AresRivas/Whame/Whame Project/Arduino SW/README.txt

Software for Arduino Nano Every, not tested in other boards. 

There are two different softwares dependind on where you are going to wear it, one for head and another for hand. 

Known bug: Some times the starting calibration fails and the system report Overflow for the YAW value, so click doesn't work. Solution: Reboot the system. 

If anyone solve this problem or preform any improve to the software please rename the code with version 1.1.
