AresRivas/Whame/Whame Project/Materials/Materials list.txt

1--> Arduino Nano Every

1--> Accelerometer MPU6050

1--> Bluetooth module Roving Networks RN42

1--> 1200 mAh LiPo Battery:

https://tienda.bricogeek.com/baterias-lipo/1135-bateria-lipo-1200mah-37v.html

1--> Power Booster & battery charger MP2636: 

https://tienda.bricogeek.com/convertidores-de-voltaje/1031-power-booster-mp2636-2a.html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 

1--> Switch:

https://tienda.bricogeek.com/interruptores/912-mini-interruptor-para-prototipado.html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

1--> FTDI Cable:

https://www.mouser.es/ProductDetail/FTDI/UMFT234XD-WE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

1--> Resistor ? 10k - 1/4W
1--> Resistor ? 22k - 1/4W  

Notes: The FTDI cable is optional for more confortable configuring the RN42 module, but it can be configured connecting it to the Arduino Nano hardware serial port (pins D0 and D1) with a simple circuit.
