AresRivas/Whame/Whame Project/3D Print Box/Micro USB Cover.stl

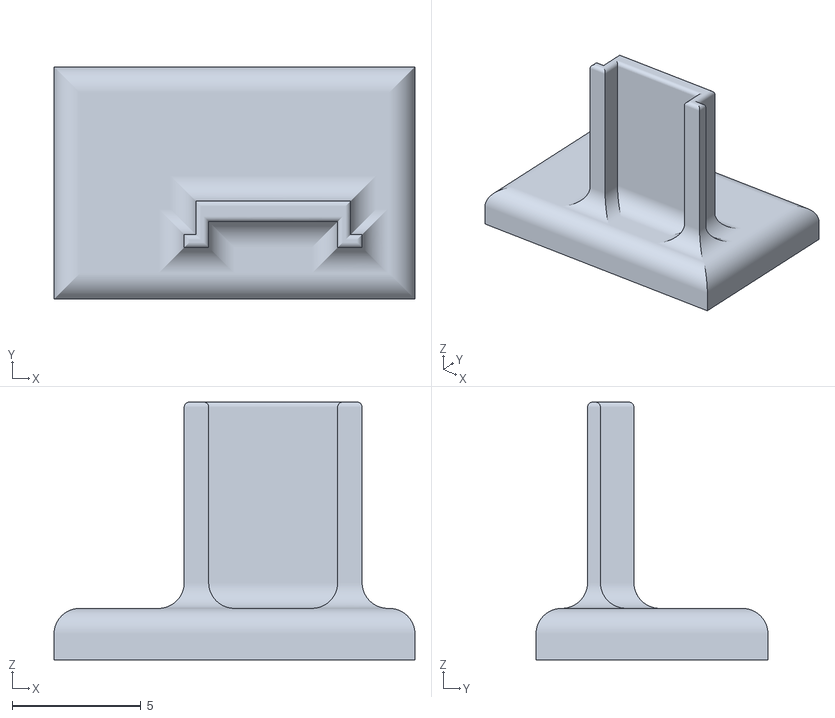
[picture p1: CAD file, 2022-05-29]
Whame Project/3D Print Box/Micro USB Cover.stl
14.0 x 9.00 x 10.0
