AresRivas/Whame/Whame Project/3D Print Box/Whame Top Cover.stl

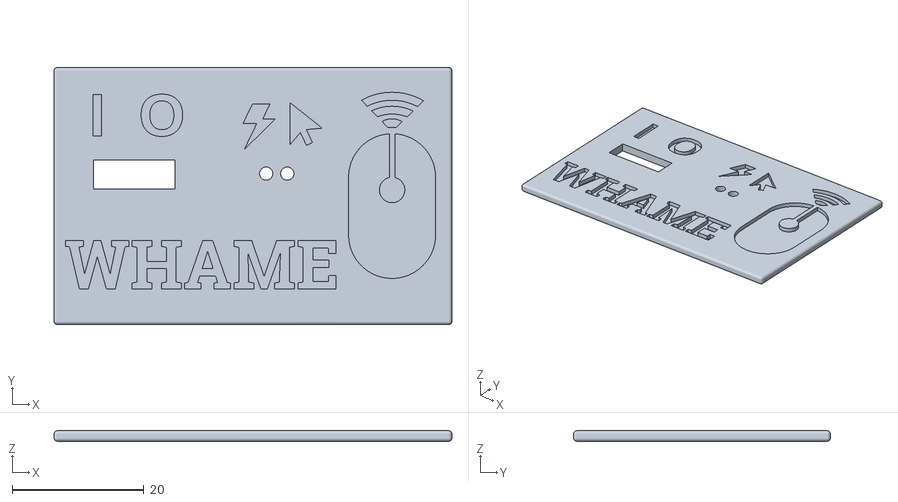
[picture p2: CAD file, 2022-05-29]
Whame Project/3D Print Box/Whame Top Cover.stl
60.4 x 39.0 x 1.60
