AresRivas/Whame/Whame Project/HW Design/PCB Model/Whame.kicad_pcb

## KiCad design Whame Project/HW Design/PCB Model/Whame.kicad_pcb (2022-06-05)

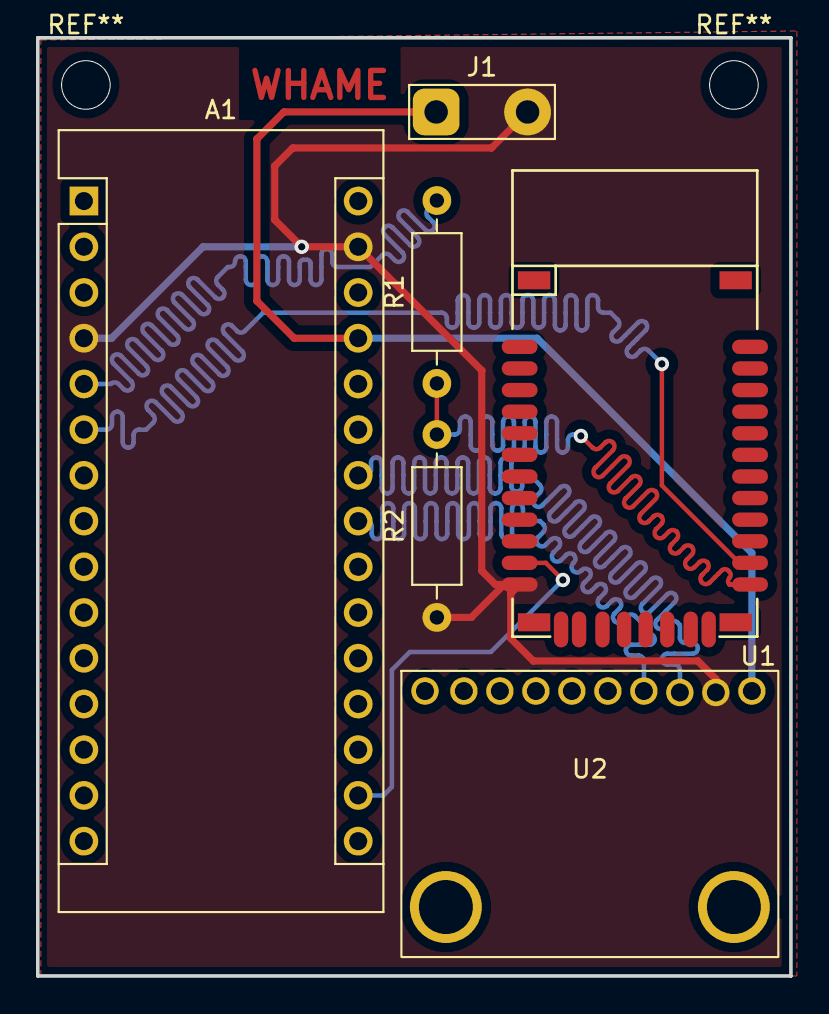
[picture p3: board Whame.kicad_pcb from above]

Board: 2 copper layers, 41.8 x 52.1 mm, 6 parts (0 on the bottom side), 8 nets.

Parts:
A1: Arduino_Nano_Every; Arduino_Nano
J1: Conn_01x02_Female; TestPoint_2Pads_Pitch5.08mm_Drill1.3mm
R1: 10k-1/2W; R_Axial_DIN0207_L6.3mm_D2.5mm_P10.16mm_Horizontal
R2: 22k-1/2W; R_Axial_DIN0207_L6.3mm_D2.5mm_P10.16mm_Horizontal
U1: RN42
U2: MPU6050; MPU_6050_pcb

Connections:
+7.5V: A1.27 (+5V), J1.1, U2.10 (REGOUT)
GND: A1.4 (GND), A1.29 (GND), J1.2, R2.1, U1.12 (GND), U2.9 (AD0)
unnamed: A1.5 (D2), R1.2
unnamed: R1.1, R2.2, U1.13 (UART_RX)
unnamed: A1.17 (3V3), U1.11 (VDD)
unnamed: A1.6 (D3), U1.14 (UART_TX)
unnamed: A1.24 (SCL/A5), U2.8 (VLOGIC)
unnamed: A1.23 (SDA/A4), U2.7 (AUX_SCL)
